smartBikeAir/soa-2017-bicicleta-inteligente/README.md

# Bicicleta inteligente
## Comisión
Lunes noche, 2do cuatrimestre 2017

## Integrantes

| |Apellido|Nombre|DNI|
| --- | --- | --- | --- |
|  | Vergara | Belen | 34705098 |
|  | Carabajal | Javier | 24715197 |
|  | Romano | Dario | 33901015 |
|  | Verdicchio | Nicolas | 36159693 |
|  | Jerez | Alex | 35169931 |
