smartBikeAir/soa-2017-bicicleta-inteligente/Arduino/pocs/README.md

# pocs
Esta carpeta contiene sketches de pruebas. El objetivo es poder probar a cada sensor/actuador de forma individual. El sketch con todo integrado lo podemos encontrar en soa-2017-bicicleta-inteligente/Arduino/BicicletaInteligente/BicicletaInteligente.ino
