smartBikeAir/soa-2017-bicicleta-inteligente/Arduino/BicicletaInteligente/Readme.md

# Sketch principal
Código fuente de la Bicicleta inteligente.
