smartBikeAir/soa-2017-bicicleta-inteligente/Arduino/pocs/alarm-basics/diagrama-estados.png

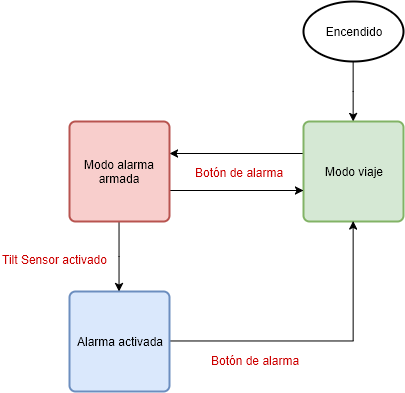
Arduino/pocs/alarm-basics/diagrama-estados.png
