smartBikeAir/soa-2017-bicicleta-inteligente/(commit log)

2017-11-26 Me traigo archivos del repositorio inicial.
    [layers_main_app.xml]
2017-11-26 Arduino - alarma cambia de frecuencia
2017-11-27 Por el momento comento pedido de localización.
2017-11-27 Correcciones en sensor proximidad.
2017-11-27 Mensajes Arduino
    Envio mensajes para arduino de configuracion.
2017-11-27 [Android] Correcciones en el uso del sensor de proximidad.
2017-11-28 [Arduino] Agrego envío de msjes BT.
2017-11-28 [Arduino] Actualizo comentario.
2017-11-28 [ANDROID] Actualizaciones
    [layers_main_app.xml]
2017-11-28 [ANDROID] Actualizacion de Constantes
2017-11-28 eliminación de bloqueo de sincronización entre threads!
2017-11-28 [Arduino] Elimino código comentado.
2017-11-28 Calculo de distancia recorrida, Android
2017-11-28 Ajustado mensaje de velocidad del lado de arduino
2017-11-29 [Arduino] Correcciones llave 3 estados.
2017-11-29 [Android] Sensor
2017-11-29 [Arduino] Corrección en lib de ultrasonido.
2017-11-29 [Android] Elimino clase que no se utiliza.
2017-11-29 [Arduino] Correcciones.
2017-11-29 [Arduino] Corrección al mandar objeto cercano.
2017-11-29 [Arduino] Corrección velocidad.
2017-11-30 [ANDROID] modificacionlog sensor
2017-11-30 [ANDROID] modificacion velocidad
2017-11-30 Identado y espaciado
    Solo prolijidad de tabulado y espaciado.
2017-11-30 Limpieza codigo
    Eliminación de código comentado.
